galagaking/wbs_AirQualityNode/README.md

# wbs_AirQualityNode
Code and intructions for the Wellbeing Solution workshop, building a TTN node with an Air Quality Sensor based on CCS811/BME280 compensated setup
