galagaking/wbs_AirQualityNode/Indoor Wellbeing Solution Part 1 of 2 - June 2018 version.pdf

## Building a TTN node

### Identifying the components

Our bill of materials (set available at TinyTronics) (http://www.tinytronics.nl/shop/Things-Network-LoRaWAN-node-Workshop)

- RFM Module RFM95W (868 Mhz)
- Pro Mini 3.3V 8Mhz (5V will NOT work!!)
- Wemos CH340 3.3v-5v TTL USB Serial Port Adapter (has to have a 3.3V option!)
- USB cable for FTDI
- Header 40p divided in: 2x 4p, 1x 6p, 1x 3p and 1x 2p
- PCB ‘DougLarue’
- Sensor BME280 (Temperature, Humidity and air pressure), (included in Sensor Addon) (https://www.tinytronics.nl/shop/nl/communicatie/rf(id)-wifi-bt/things-network-indoor-wellness-sensor-addon)

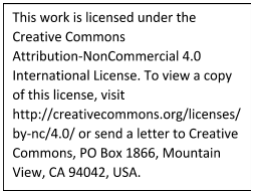
[picture p1: figure]

- CCS811 CO2 / tVoC sensor (included in Sensor Addon) (https://www.tinytronics.nl/shop/nl/communicatie/rf(id)-wifi-bt/things-network-indoor-wellness-sensor-addon)
- Battery holder 2x AA
- 2 AA batteries
- 1x female header 2p (battery connection)

### Low Power the Arduino?

There is an option to ‘low power’ the Arduino. BUT this requires some precise soldering! The setup will work without removing the components. If you want to low power your node, look at https://andreasrohner.at/posts/Electronics/How-to-modify-an-Arduino-Pro-Mini-clone-for-low-power-consumption/ (https://andreasrohner.at/posts/Electronics/How-to-modify-an-Arduino-Pro-Mini-clone-for-low-power-consumption/) for more information.

## Building the Node

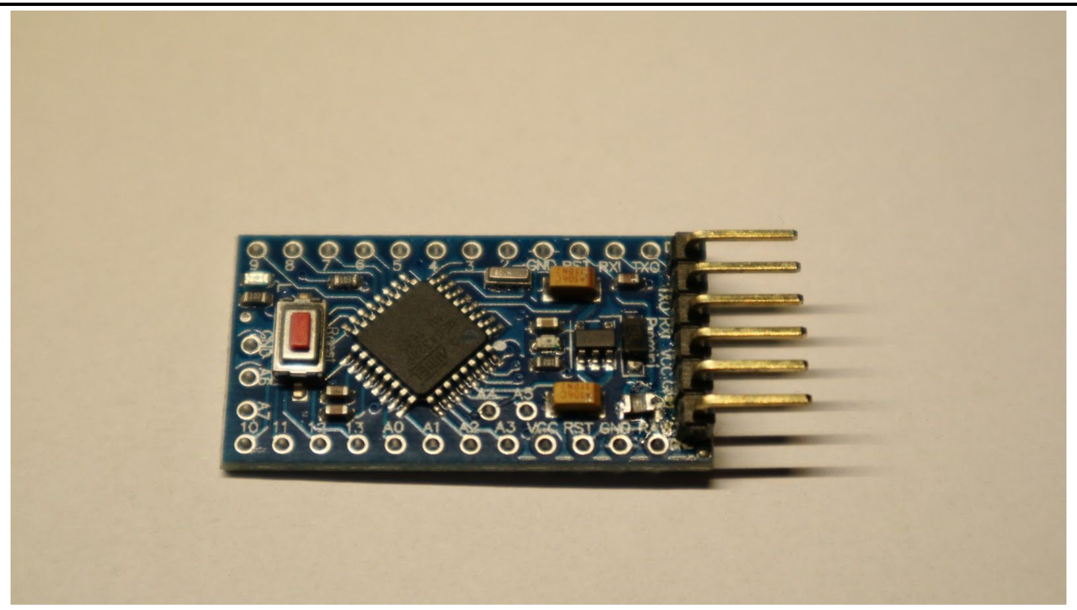
[picture p2: figure]

Solder the 6p male header
onto the Arduino PCB

This work is licensed under the Creative Commons Attribution-NonCommercial 4.0 International License. Page 1

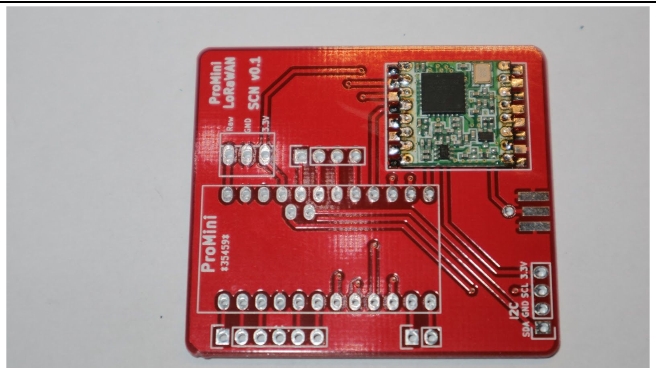
[picture p3: figure]

Position the RFM95 radio chip, you might use some Tesla tape to fix it. The crystal should be in the right lower corner (as shown in the picture). Start with just a little solder in two opposite corners.

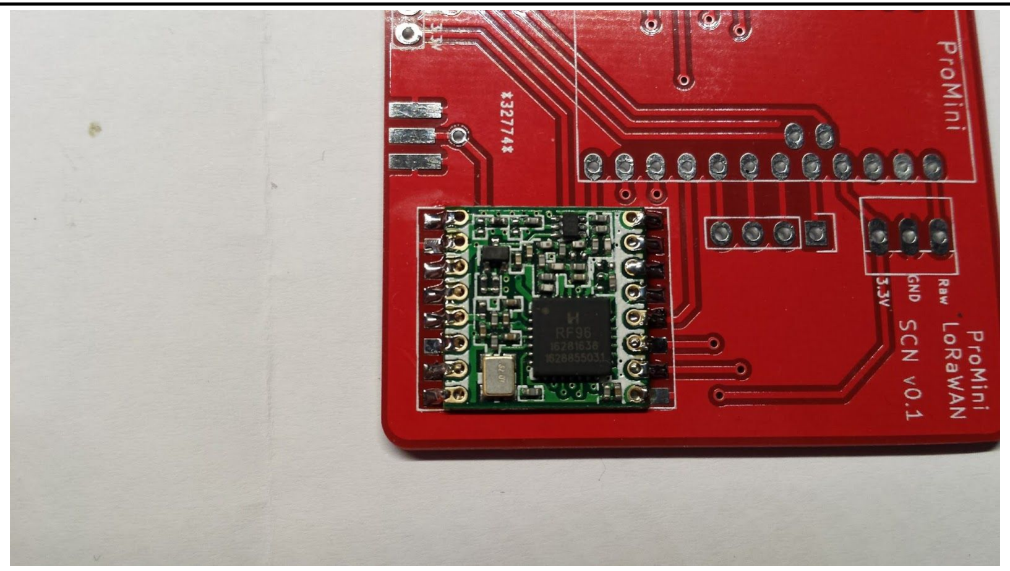
[picture p4: figure]

Align the solder pads and if the module is in place, solder the other pads. Do use as little as possible solder! Check the connections carefully!

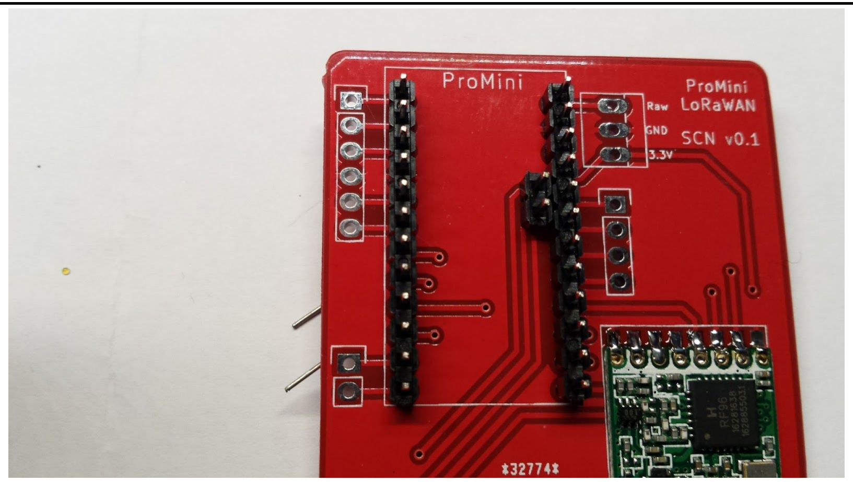
[picture p5: figure]

Put two 12p headers into the ProMini socket. Also put the 2p header inside the ProMini area. By holding them with a piece of paper you can turn around the PCB. (You can also use the ProMini to keep the pins in place by using an elastic band.)

This work is licensed under the Creative Commons Attribution-NonCommercial 4.0 International License. Page 2

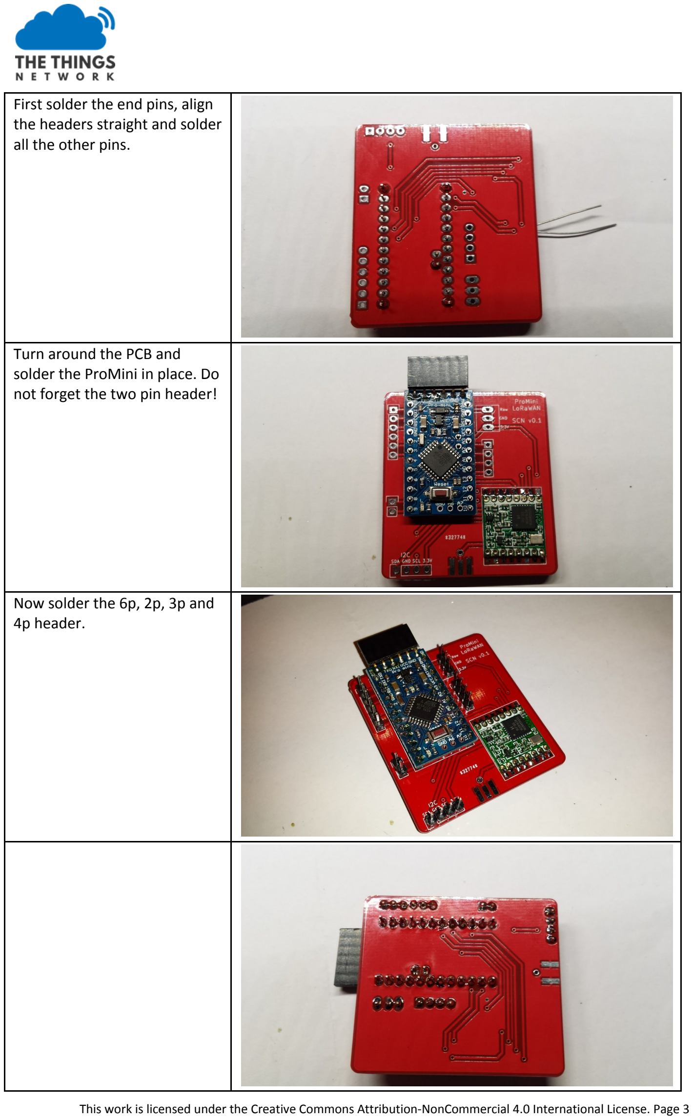
[picture p6: page 3]

First solder the end pins, align the headers straight and solder all the other pins.

Turn around the PCB and solder the ProMini in place. Do not forget the two pin header!

Now solder the 6p, 2p, 3p and 4p header.

This work is licensed under the Creative Commons Attribution-NonCommercial 4.0 International License. Page 3

Cut a piece of wire, length 82.2 mm. This is a ¼ wave length antenna. You may add some short soldering end. | Wavelength =300/868 = 0.3456m Wavelength /4 = 0,0864 m correction 0.95*0.0864=0.0822m (to determine the precise length you can do some experiments, or use proper test equipment like a SWR meter)

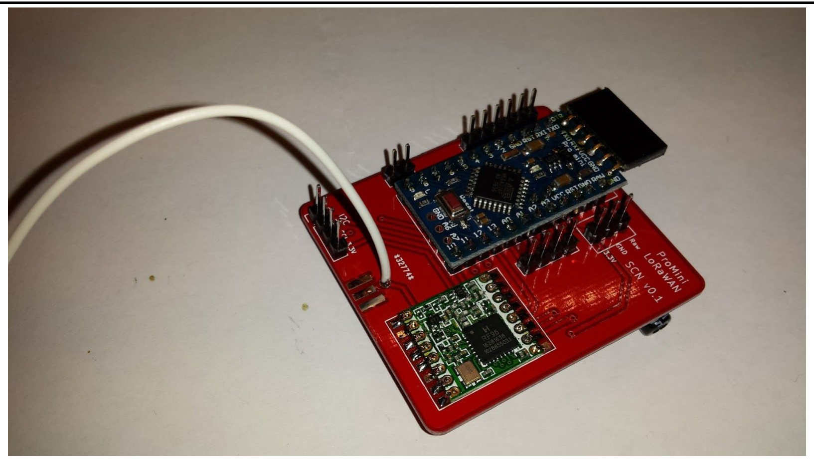
[picture p7: figure]

Solder the Antenna into the hole near the connector pins. It is also possible to solder a SMA edge connector.

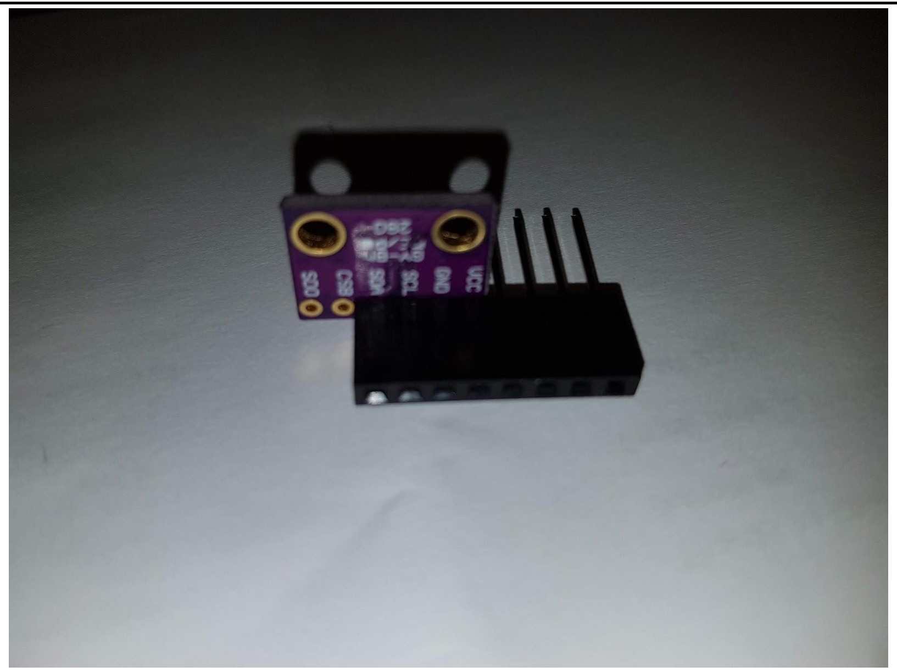
[picture p8: figure]

Solder a header on the BME280 barometric sensor. You may use a ‘Arduino Header’ so you can use both sides to connect your wires.

This work is licensed under the Creative Commons Attribution-NonCommercial 4.0 International License. Page 4

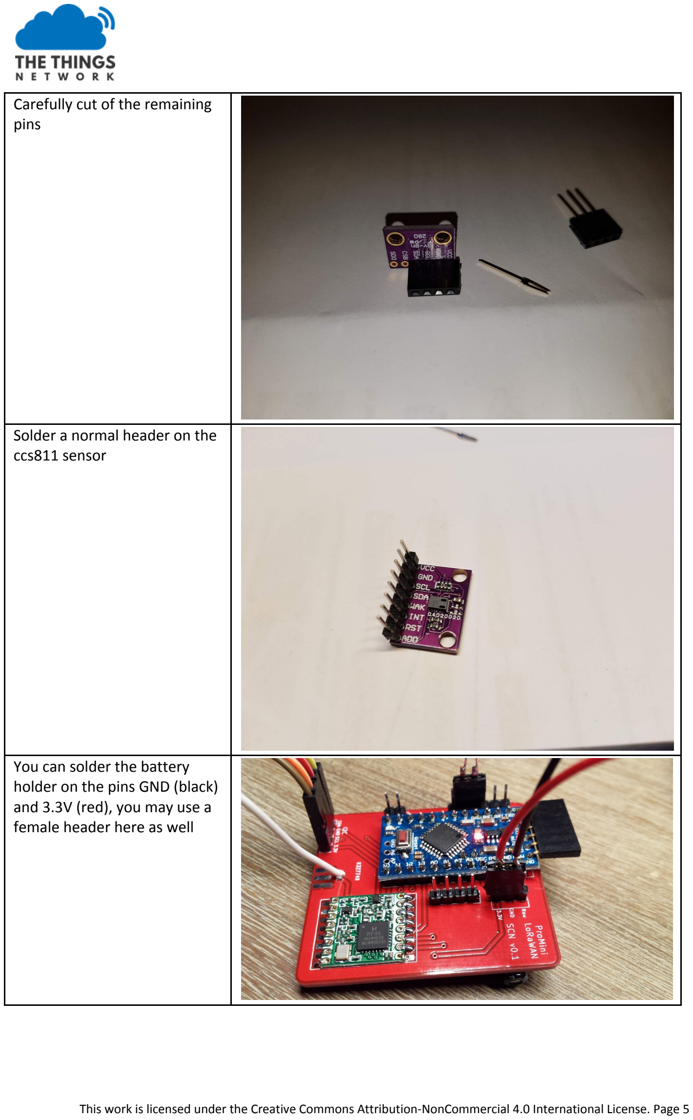
[picture p9: page 5]

Carefully cut of the remaining pins

Solder a normal header on the ccs811 sensor

You can solder the battery holder on the pins GND (black) and 3.3V (red), you may use a female header here as well

This work is licensed under the Creative Commons Attribution-NonCommercial 4.0 International License. Page 5

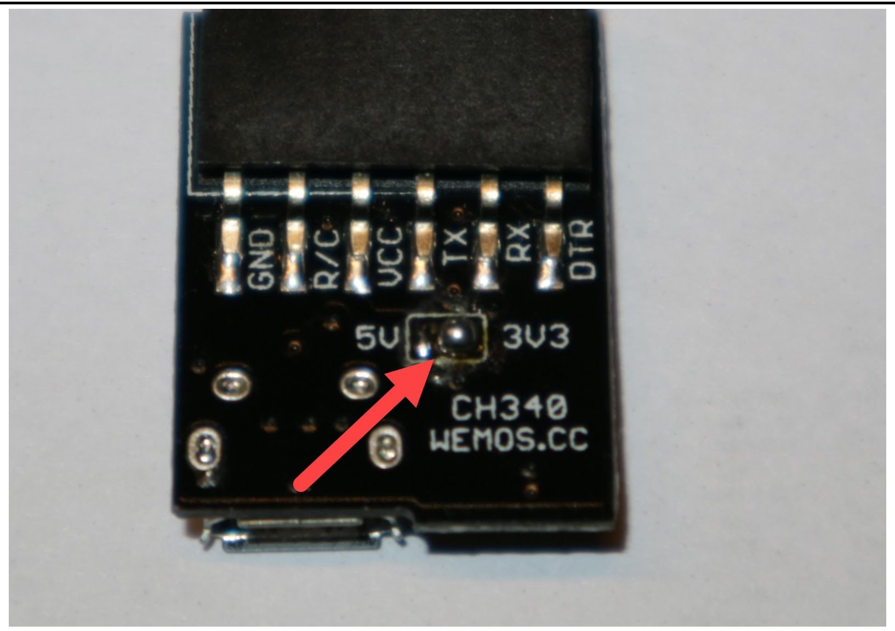
[picture p10: figure]

Ensure the soldering bridge on the FTDI is on the 3v3 position

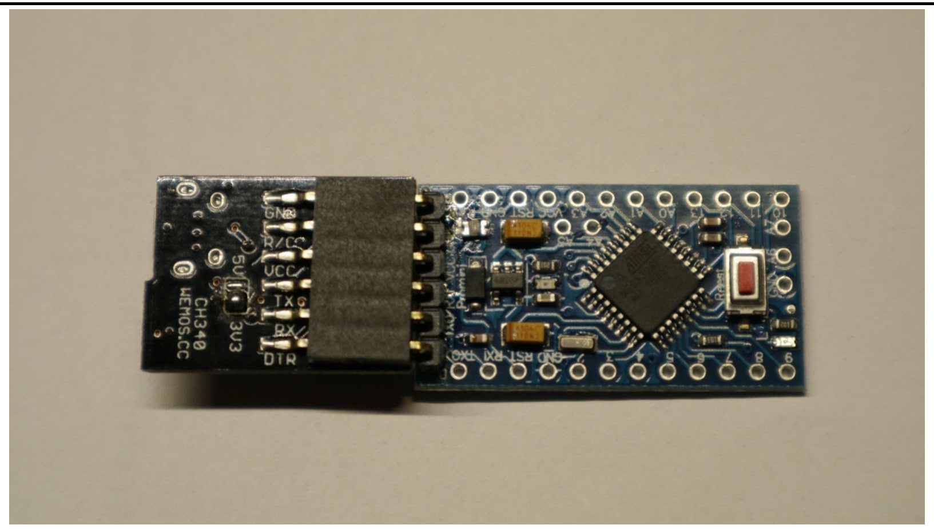
[picture p11: figure]

Connect the FTDI board to the Arduino as shown. DTR should match DTR, GND to GND, Vcc to Vcc, Tx To Rx and Rx to Tx. Check your wiring and connect the FTDI board to your PC.

## Starting up the Arduino Environment

https://www.arduino.cc/en/Guide/HomePage

Install the Arduino IDE on your favourite platform (Mac, Linux or Windows). These examples are tested with Arduino IDE (tested on 1.8.0)!

https://www.arduino.cc/en/Guide/ArduinoProMini

Use the FTDI, ensure that the jumper or bridge is on the ‘3V’ side. Battery power turned off (check the switch).

People using a MAC have a look at this site to update their drivers: https://kig.re/2014/12/31/how-to-use-arduino-nano-mini-pro-with-CH340G-on-mac-osx-yosemite.ht ml (https://kig.re/2014/12/31/how-to-use-arduino-nano-mini-pro-with-CH340G-on-mac-osx-yosemite.html)

Connect the FTDI and the Pro Mini as shown in the pictures, align the signals: DTR should match DTR, GND to GND, Vcc to Vcc, Tx To Rx and Rx to Tx.

This work is licensed under the Creative Commons Attribution-NonCommercial 4.0 International License. Page 6

- Start the Arduino IDE
- Select the board: ‘Arduino Pro or Pro mini’
- Select the Processor ‘ATmega328 (3.3V, 8Mhz) -> IMPORTANT TO SELECT THE RIGHT CLOCK FREQUENCY!!

●

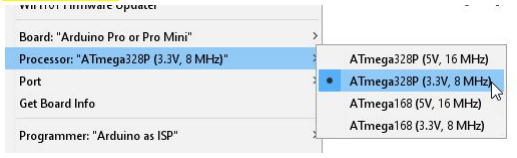
[picture p12: figure]

- Select the COM port given

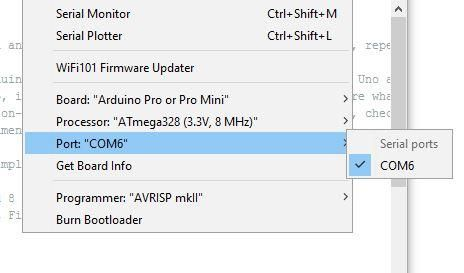
[picture p13: figure]
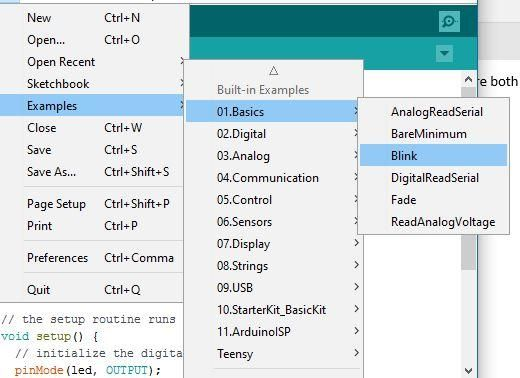
[picture p14: figure]

Select the default ‘BLINK’ example,

Load the code with CTRL-U to the Pro Mini. After compilation and uploading the onboard led should blink at 1 Hz. Great: we have a working programming environment! (Be Aware that pin 13 / onboard LED is used by the RFM95 module as well, so you can NOT use the onboard LED if you want to connect to The Things Network).

### Testing the sensors

- Add the BME280 library: Sketch-> include library -> manage libraries:
- Search for BME280 and select the Sparkfun BME280 library:

This work is licensed under the Creative Commons Attribution-NonCommercial 4.0 International License. Page 7

●

- Search for the Sparkfun CCS811 library and install this one as well:

●

- Connect the BME280 sensor: Connect the BME280 sensor with female-female jumper wires to the I2C connector:
- GND-> GND
- SDA->SDA
- SCL->SCL
- VCC->+3.3V

The CSB en SDO are left open (only used in SPI connection). You can not connect straight forward, but you should twist the two wires in the middle. Leave the four ‘female’ connectors open, we will connect the CCS811 later.

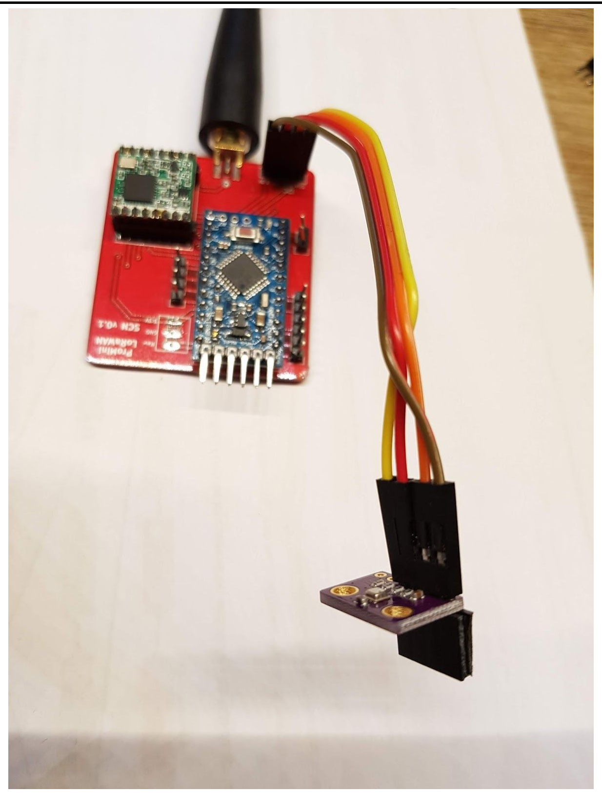
[picture p15: figure]

- Now connect the CCS811 sensor. This one is connected to the same I2C bus:

This work is licensed under the Creative Commons Attribution-NonCommercial 4.0 International License. Page 8

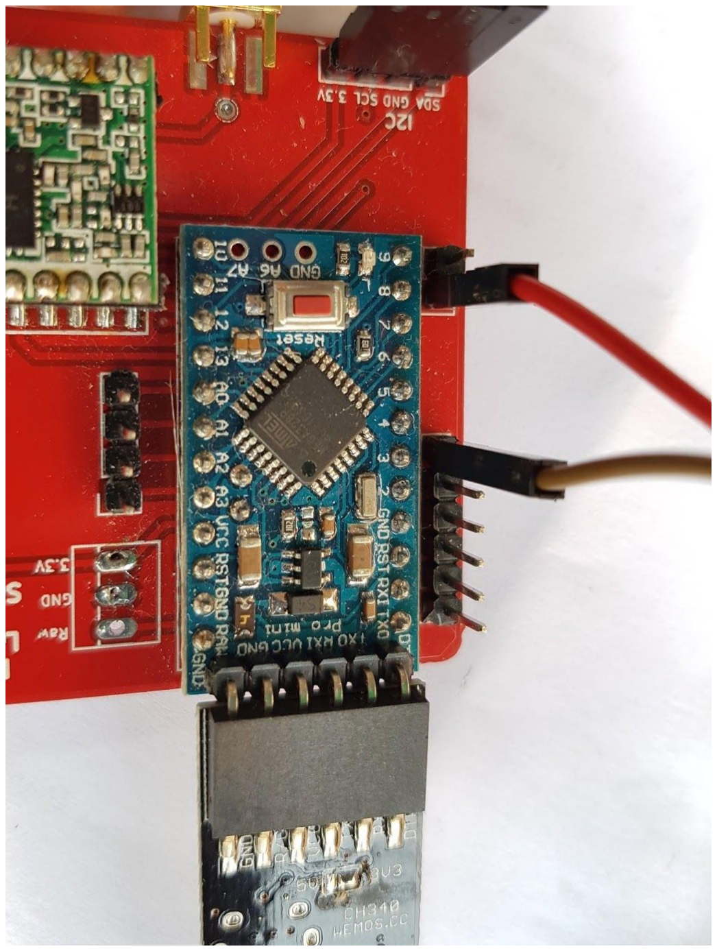
[picture p16: figure]

Connect the CC811 sensor with four male-female jumper wires straightthru to the I2C connector:

- GND-> GND
- SDA->SDA
- SCL->SCL
- VCC->VCC

Use two female-female jumper wires to connect WAK and INT to the Main Board:

- WAK -> PIN 8
- INT -> PIN 3

Look at the Arduino pin numbers to select the right pin.

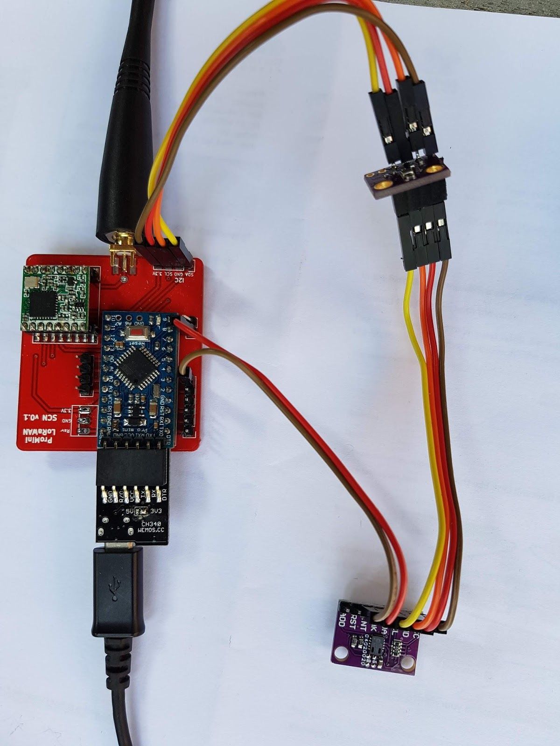
[picture p17: figure]

- Get the code from https://github.com/galagaking/wbs_AirQualityNode , wbs_Testing_BME280_CCS811.ino
- Compile and Upload the code to your node.
- By opening the Serial Monitor (9600 bps) you will see the CO2, tVoC, height, pressure, humidity and temperature of both sensors. Put your finger on the BME sensor (the small metal unit) and see the temperature rise. The sensor’s height is relative and this library has a ‘fixed’ sea level pressure is 1013.25 mBar (you might want to change it at the end of the SparkFunBME280.h file).
- If there are any errors, first check your wiring, if the values still not show up, you may alter the I2C bus addresses as stated in the code, or first start with the wbs_Testing_BME280.ino example. Also check the availability of the TWO SparkFun libraries.

This work is licensed under the Creative Commons Attribution-NonCommercial 4.0 International License. Page 9

●

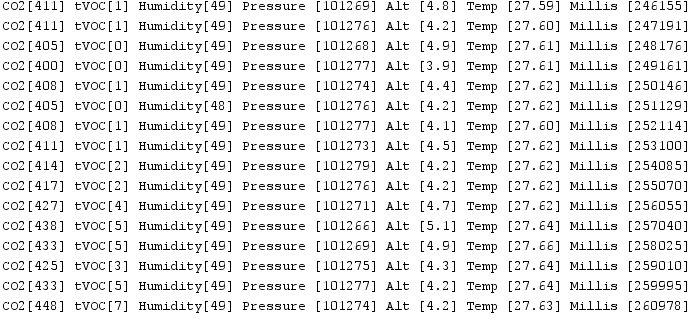
[picture p18: figure]

## Getting things started on ‘The Things Network’

Close your Arduino IDE software. Remove (if already installed) the current LMIC library. We will use the ‘Charles’ version of the library. This one is compatible with your other projects, but has some special functionality needed for the WeMos LoRa board (supporting one input pin for the three DIO pins).

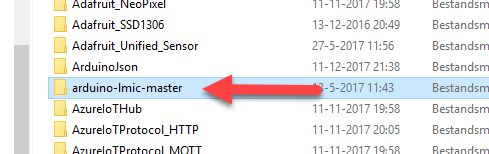
[picture p19: figure]

Download the new library and install the .zip file with library manager:
1. Goto https://github.com/ch2i/arduino-lmic
2. Choose ‘Clone or download’
3. Download ZIP
4. Mark the location
5. Go to Arduino IDE
6. Select ‘Sketch->Include Library->Add .ZIP Library’
7. Select the downloaded Arduino-lmic-master.zip file from your download location

Change the ‘lmic_project_config.h’ file in the project_config folder (remove the remark from CFG_eu868 and add them to CFG_us915):

//#define CFG_us915 1
#define CFG_eu868 1

#define CFG_sx1276_radio 1

Now install the Low Power library:
1. Goto https://github.com/rocketscream/Low-Power
2. Choose ‘Clone or Download’
3. Download ZIP
4. Mark the location
5. Go to Arduino IDE

This work is licensed under the Creative Commons Attribution-NonCommercial 4.0 International License. Page 10

6. Select ‘Sketch->Include Library->Add .ZIP Library’
7. Select the downloaded low-power-master.zip file from your download location

## The Things Network Dashboard

Your applications and devices can be managed by The Things Network Dashboard.

### Create an Account

To use the dashboard, you need a The Things Network account. You can create an account here:

https://account.thethingsnetwork.org/users/login .

After registering and validating your email address, you will be able to log in to The Things Network Dashboard.

### Create an Application

https://console.thethingsnetwork.org/applications

Choose ‘add application’

Give your Application a name, you can ONLY use lowercase! Your description can be any description you like. Choose ‘Add application’

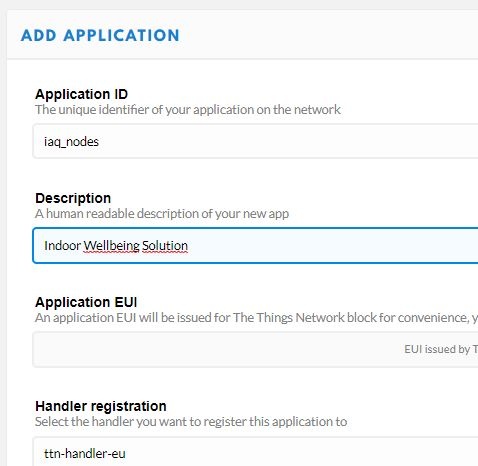
[picture p20: figure]

### ABP

Activation by Personalization (ABP) is a method where the security keys are stored in the device. Not as safe as the OTAA method, but for experiments it works OK. There is no join procedure, nodes will work right away. Choose ‘register device’:

This work is licensed under the Creative Commons Attribution-NonCommercial 4.0 International License. Page 11

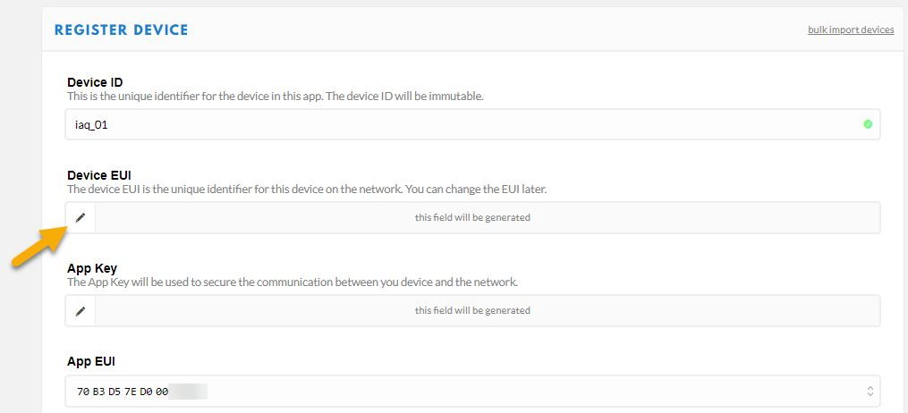
[picture p21: figure]

Enter a Device ID (lower case), and choose to generate the Device EUI (a pencil will show up).

Choose Register.

Now edit the settings (at the upper right of the screen) of the device and choose ABP (OTAA will be selected by default), and uncheck the frame counter check checkbox

This work is licensed under the Creative Commons Attribution-NonCommercial 4.0 International License. Page 12

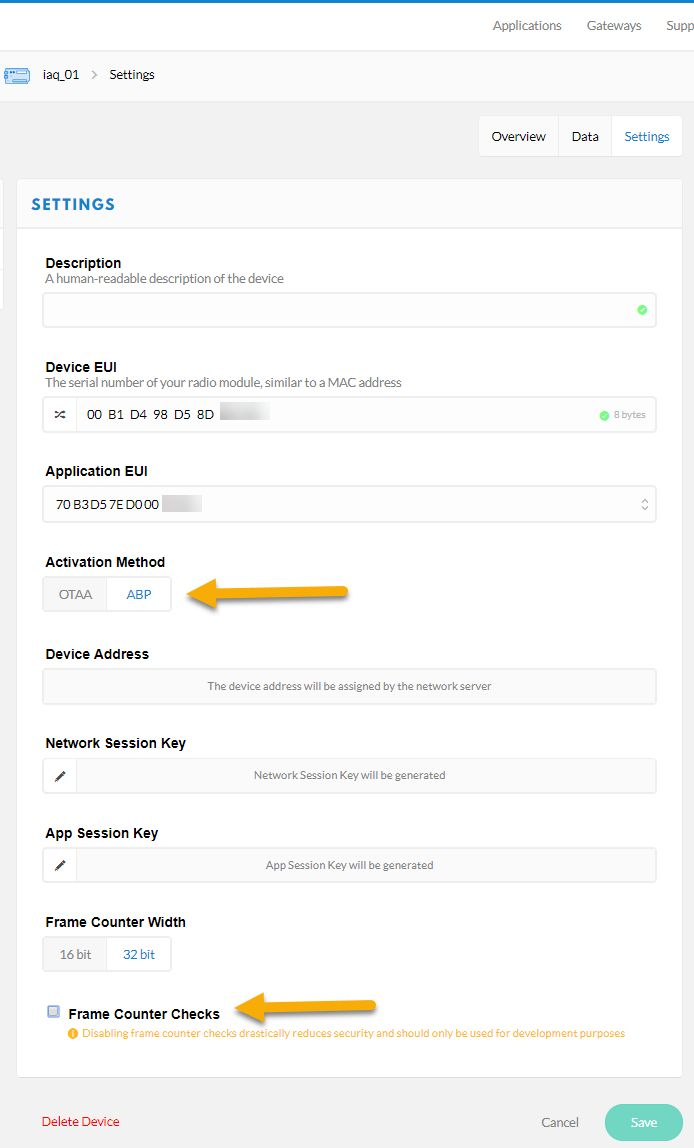
[picture p22: figure]

Select ‘save’. Now some values are system generated and we have to copy them to our code. Get the

This work is licensed under the Creative Commons Attribution-NonCommercial 4.0 International License. Page 13

code from
https://github.com/galagaking/wbs_AirQualityNode/blob/master/wbs_BME280_CCS811.ino.

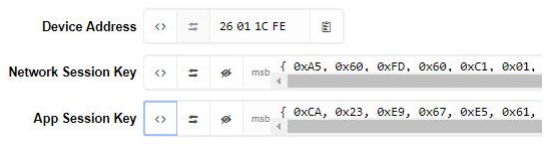
[picture p23: figure]

- Copy the Device Address as a HEX value to DEVADDR in the example, so 26 01 1C FE will be 0x26011CFE.
- Copy the Network Session Key as MSB to NWSKEY. (use the ‘<>’ and arrow button to change LSB/MSB and code presentation)
- Copy the App Session Key as MSB to APPSKEY. (use the ‘<>’ and arrow button to change LSB/MSB and code presentation)

Compile and upload the code. Check in the dashboard the working.

To get the right display format, we can create a decoder in our application. Select your application and open the ‘Payload Functions’:

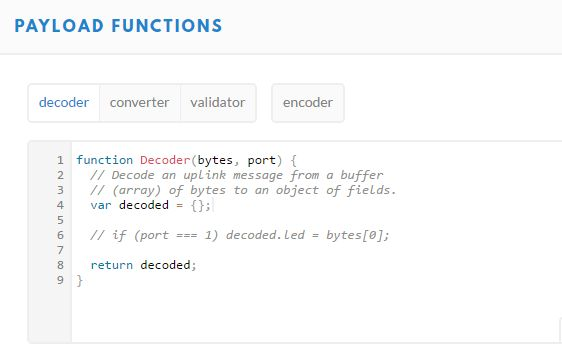
[picture p24: figure]

Get the payload function from the program code or from Payload.js in Github.

This work is licensed under the Creative Commons Attribution-NonCommercial 4.0 International License. Page 14

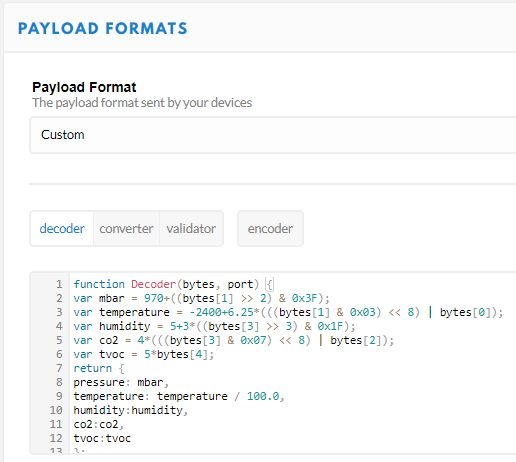
[picture p25: figure]

Save the function. Return to your data and look what happens:

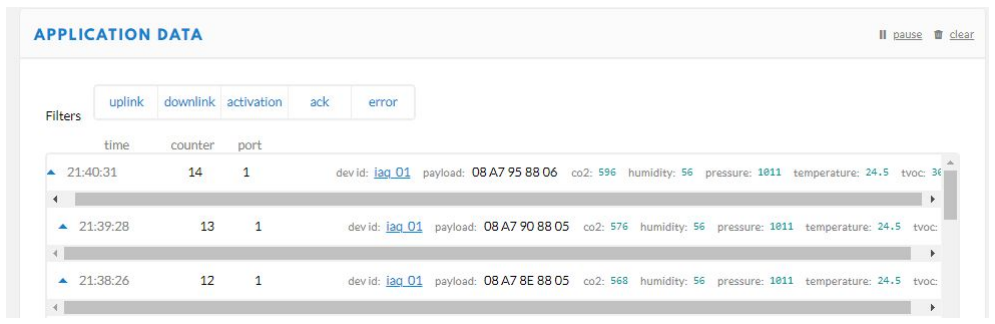
[picture p26: figure]

This way you can put several values into a byte string. Sending in clear ASCII is possible but due to bandwidth limitations not preferable in production environments. To make this even more scalable take a look at https://github.com/thesolarnomad/lora-serialization .

### Burn in and stabilization

The CCS811 sensor has a resistor component which needs some burn-in time. The onboard processor of the sensor will take care. In normal use it will last approx 10 minutes to get proper results (CO2>0) and over time the sensor will act more precise after 48 hours ‘burn-in’ time.

### Power Consumption

If you have removed the power LED on the Arduino, the node with the sensors will use 32uA power between the measurements, and 1.3mA during measurement and sending the data (once a minute). This gives approx. a week battery life.

This work is licensed under the Creative Commons Attribution-NonCommercial 4.0 International License. Page 15

### TTN Mapper

On www.ttnmapper.org you can look at the coverage of The Things Network in your neighbourhood.

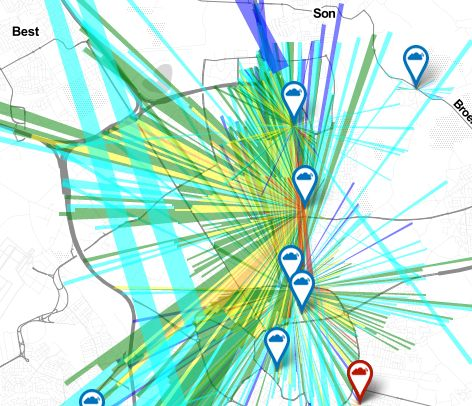
[picture p27: figure]

You can even contribute to this map by using the ttnmapper app on your Android Smartphone. You can use your TTN credentials to select your sensor

### LMIC Pin Mapping

If you are using other ‘LMIC’ or TTN examples, there is ONE part to take care of, the pin setting of the RFM95 module. Most times you have to adjust this to the pinout of the board:

// Pin mapping is hardware specific const lmic_pinmap lmic_pins = { .nss = 10,
.rxtx = LMIC_UNUSED_PIN,
.rst = LMIC_UNUSED_PIN,
.dio = {4, 5, 7}, //DIO0, DIO1 and DIO2 connected };

### And even more…

- You can add professional Antenna’s on the PCB by using the appropriate connector.
- Support: https://www.thethingsnetwork.org/forum/

Thanks to Doug Larue for his PCB design and sharing his manuals.

Frank Beks

June 2018

This work is licensed under the Creative Commons Attribution-NonCommercial 4.0 International License. Page 16
